Tutu72byte/Guitar-effects-processor---Hardware/3D_MODEL.png

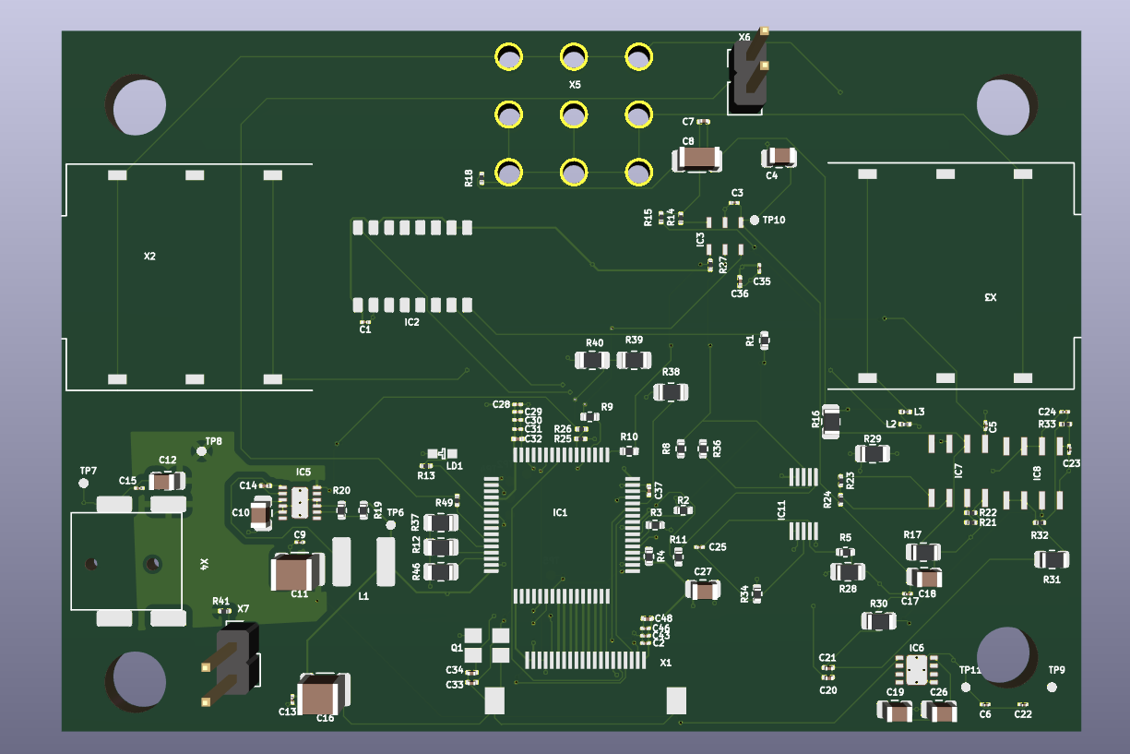
3D_MODEL.png
