Tutu72byte/Guitar-effects-processor---Hardware/Block_Diagram.png

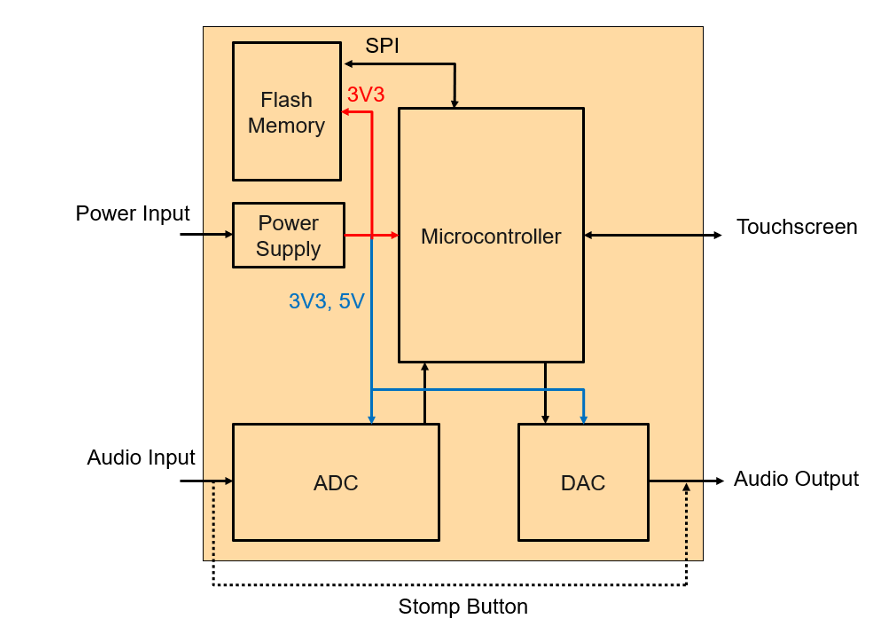
Block_Diagram.png
