Tutu72byte/Guitar-effects-processor---Hardware/PCB.png

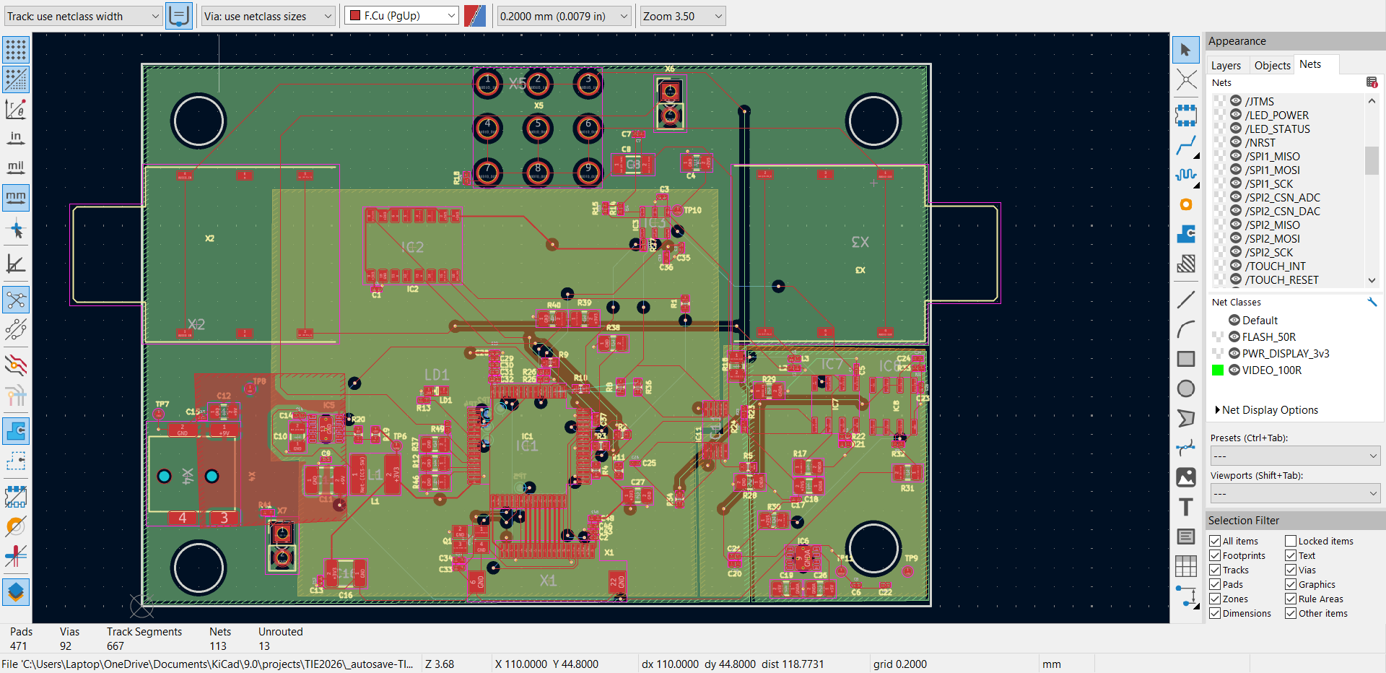
PCB.png
