Tutu72byte/Guitar-effects-processor---Hardware/SCHEMATIC.png

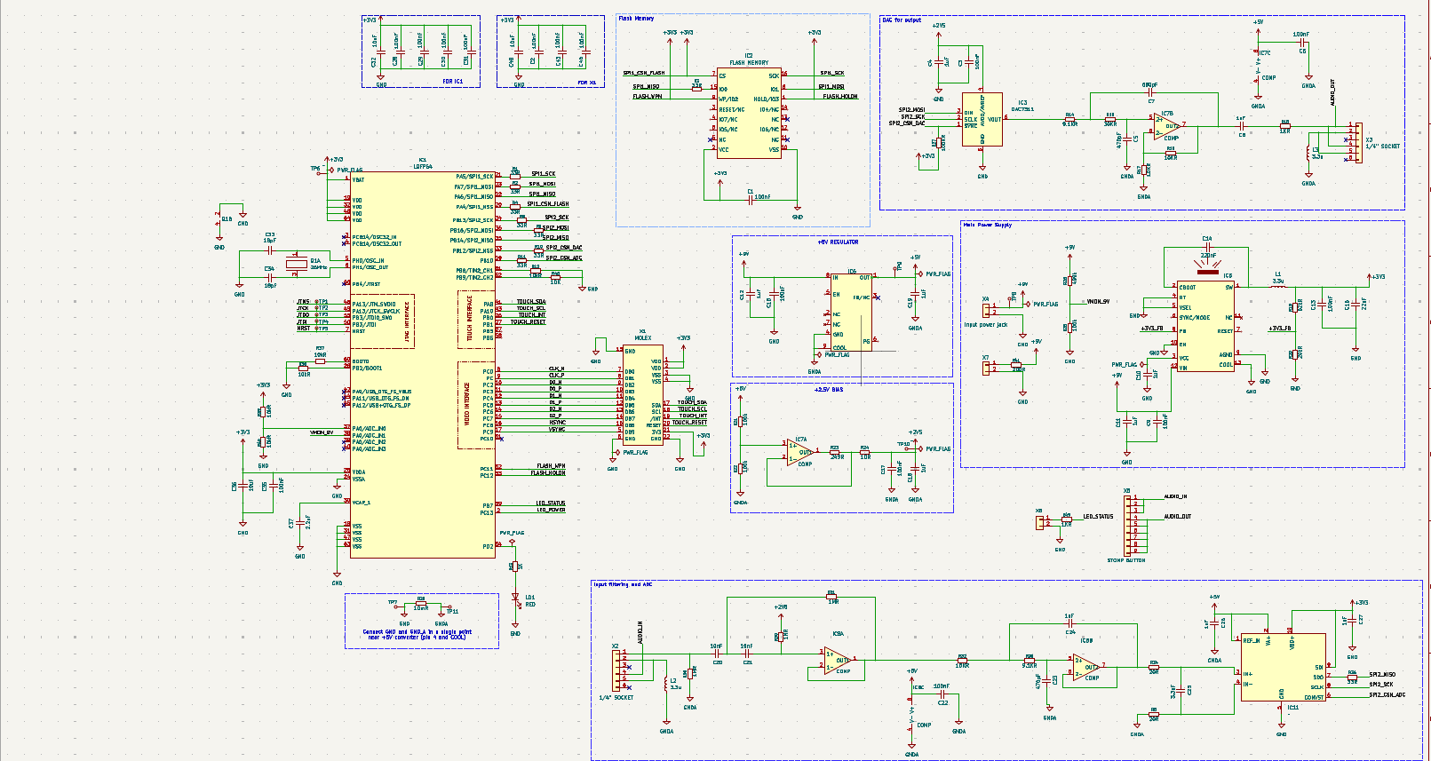
SCHEMATIC.png
