Tutu72byte/Guitar-effects-processor---Hardware/fabrication/BOM/TIE2026_BOM.csv

Reference | Qty | Value | DNP | Exclude from BOM | Exclude from Board | Footprint | Datasheet
C1,C2,C3,C6,C9,C13,C15,C17,C22,C28,C29,C30,C31,C35,C43,C46 | 16 | 100nF |  |  |  | Capacitor_SMD:C_01005_0402Metric | ~
C4,C10,C12,C18,C19,C26,C27 | 7 | 1uF |  |  |  | Capacitor_SMD:C_0805_2012Metric | ~
C5,C23 | 2 | 470pF |  |  |  | Capacitor_SMD:C_01005_0402Metric | ~
C7 | 1 | 680pF |  |  |  | Capacitor_SMD:C_0201_0603Metric | ~
C8 | 1 | 1uF |  |  |  | Capacitor_SMD:C_1206_3216Metric | ~
C11 | 1 | 1uF |  |  |  | Capacitor_SMD:C_1210_3225Metric | ~
C14 | 1 | 220nF |  |  |  | Capacitor_SMD:C_0201_0603Metric | ~
C16 | 1 | 22uF |  |  |  | Capacitor_SMD:C_1210_3225Metric | ~
C20,C21 | 2 | 10nF |  |  |  | Capacitor_SMD:C_0201_0603Metric | ~
C24 | 1 | 1nF |  |  |  | Capacitor_SMD:C_01005_0402Metric | ~
C25 | 1 | 3.3nF |  |  |  | Capacitor_SMD:C_01005_0402Metric | ~
C32,C36,C48 | 3 | 10uF |  |  |  | Capacitor_SMD:C_0201_0603Metric | ~
C33,C34 | 2 | 18pF |  |  |  | Capacitor_SMD:C_0201_0603Metric | ~
C37 | 1 | 2.2uF |  |  |  | Capacitor_SMD:C_0201_0603Metric | ~
IC1 | 1 | LQFP64 |  |  |  | TIE2026:IC1_LQFP64
IC2 | 1 | FLASH MEMORY |  |  |  | TIE2026:IC2_SO16
IC3 | 1 | DAC7311 |  |  |  | TIE2026:IC3_TSOP6 | https://www.ti.com/lit/ds/symlink/dac5311.pdf
IC5 | 1 | ~ |  |  |  | TIE2026:IC5_WSON12
IC6 | 1 | TPS74501PQWDRBRQ1 |  |  |  | TIE2026:IC6_SONB
IC7,IC8 | 2 | COMP |  |  |  | TIE2026:8AB_PDS08 | ~
IC11 | 1 | ~ |  |  |  | TIE2026:IC11_VSSOP
L1 | 1 | 3.3u |  |  |  | TIE2026:L1_NRS5040 | ~
L2,L3 | 2 | 3.3u |  |  |  | Inductor_SMD:L_0201_0603Metric | ~
LD1 | 1 | RED |  |  |  | TIE2026:LD1_PLCC | ~
Q1 | 1 | ~ |  |  |  | TIE2026:Q1_NX3225
R1,R2,R3,R4,R8,R9,R10,R11,R36 | 9 | 33R |  |  |  | Resistor_SMD:R_0402_1005Metric | ~
R5,R34 | 2 | 20R |  |  |  | Resistor_SMD:R_0402_1005Metric | ~
R12,R37,R38,R39,R40 | 5 | 10kR |  |  |  | Resistor_SMD:R_0805_2012Metric | ~
R13 | 1 | 1K |  |  |  | Resistor_SMD:R_0201_0603Metric | ~
R14,R33 | 2 | 9.1KR |  |  |  | Resistor_SMD:R_0201_0603Metric | ~
R15 | 1 | 30KR |  |  |  | Resistor_SMD:R_0201_0603Metric | ~
R16,R17 | 2 | 10KR |  |  |  | Resistor_SMD:R_0805_2012Metric | ~
R18,R49 | 2 | 1KR |  |  |  | Resistor_SMD:R_0201_0603Metric | ~
R19 | 1 | 62kR |  |  |  | Resistor_SMD:R_0402_1005Metric | ~
R20 | 1 | 20kR |  |  |  | Resistor_SMD:R_0402_1005Metric | ~
R21,R22,R25 | 3 | 100k |  |  |  | Resistor_SMD:R_0201_0603Metric | ~
R23 | 1 | 249R |  |  |  | Resistor_SMD:R_0201_0603Metric | ~
R24 | 1 | 10R |  |  |  | Resistor_SMD:R_0201_0603Metric | ~
R26 | 1 | 499k |  |  |  | Resistor_SMD:R_0201_0603Metric | ~
R27 | 1 | 100KR |  |  |  | Resistor_SMD:R_0201_0603Metric | ~
R28 | 1 | 10mR |  |  |  | Resistor_SMD:R_0805_2012Metric | ~
R29,R30,R31 | 3 | 1MR |  |  |  | Resistor_SMD:R_0805_2012Metric | ~
R32 | 1 | 15KR |  |  |  | Resistor_SMD:R_0201_0603Metric | ~
R41 | 1 | 200R |  |  |  | Resistor_SMD:R_0201_0603Metric | ~
R46 | 1 | 10K |  |  |  | Resistor_SMD:R_0805_2012Metric | ~
TP1,TP2,TP3,TP4,TP5,TP6,TP7,TP8,TP9,TP10,TP11 | 11 | ~ |  |  |  | TIE2026:TEST_POINT_TIE2026 | ~
X1 | 1 | MOLEX |  |  |  | TIE2026:X1_MOLEX
X2,X3 | 2 | 1/4" SOCKET |  |  |  | TIE2026:QInch_Jack | ~
X4 | 1 | Input power jack |  |  |  | TIE2026:ADC_021_3 | ~
X5 | 1 | STOMP BUTTON |  |  |  | TIE2026:XC5_MC71101 | ~
X6,X7 | 2 | CONN_2.54 |  |  |  | Connector_PinHeader_2.54mm:PinHeader_1x02_P2.54mm_Vertical | ~
