Tutu72byte/Guitar-effects-processor---Hardware/TIE2026.kicad_pcb

## KiCad design TIE2026.kicad_pcb (2026-05-31)

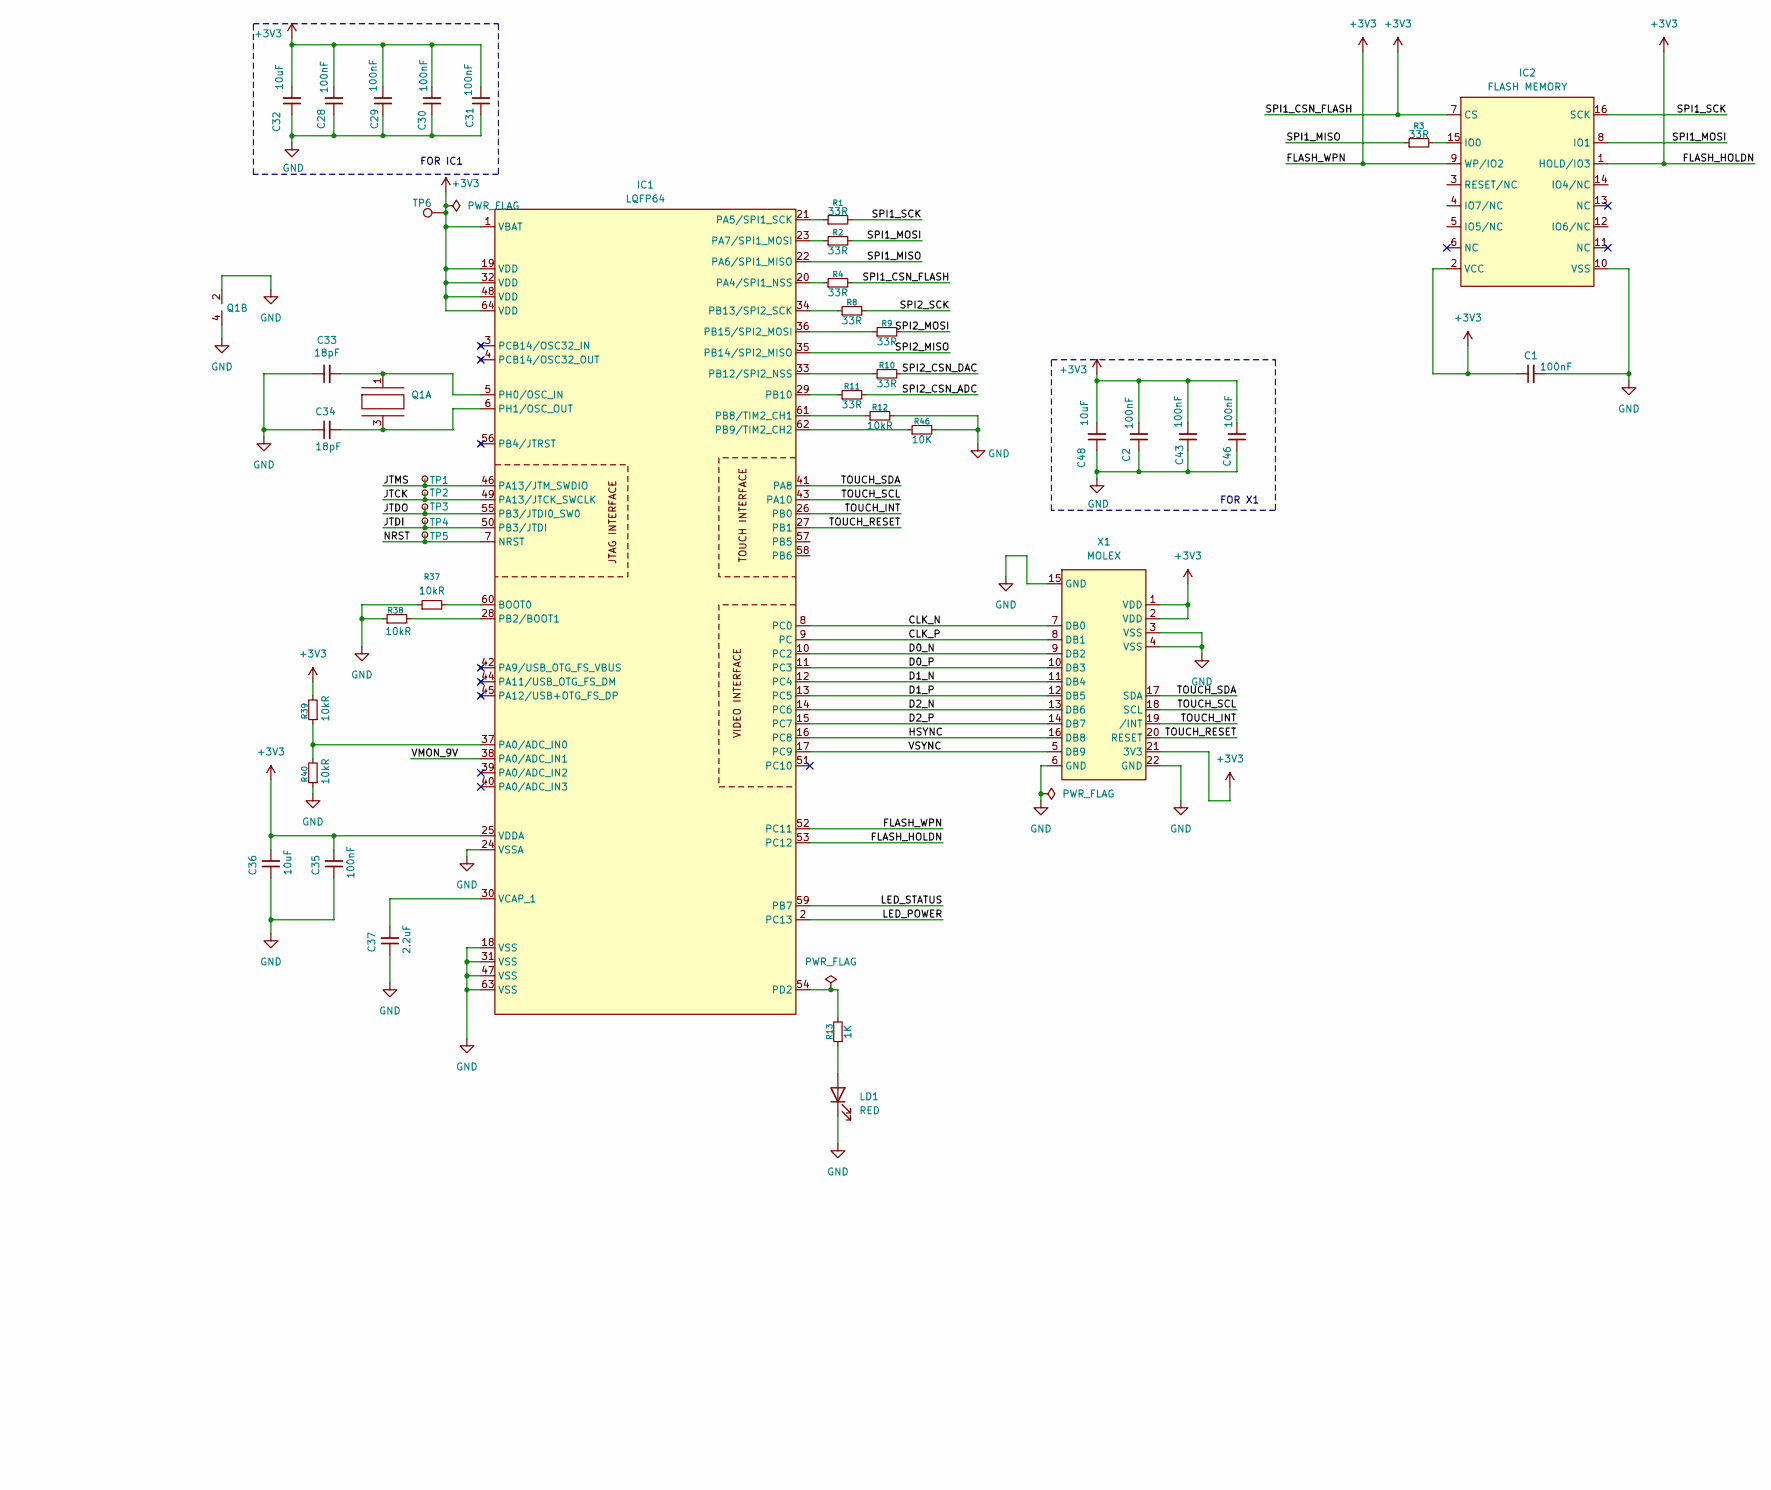
[picture p5: schematic TIE2026.kicad_sch, SCH TIE AA, part in row 1, column 2]

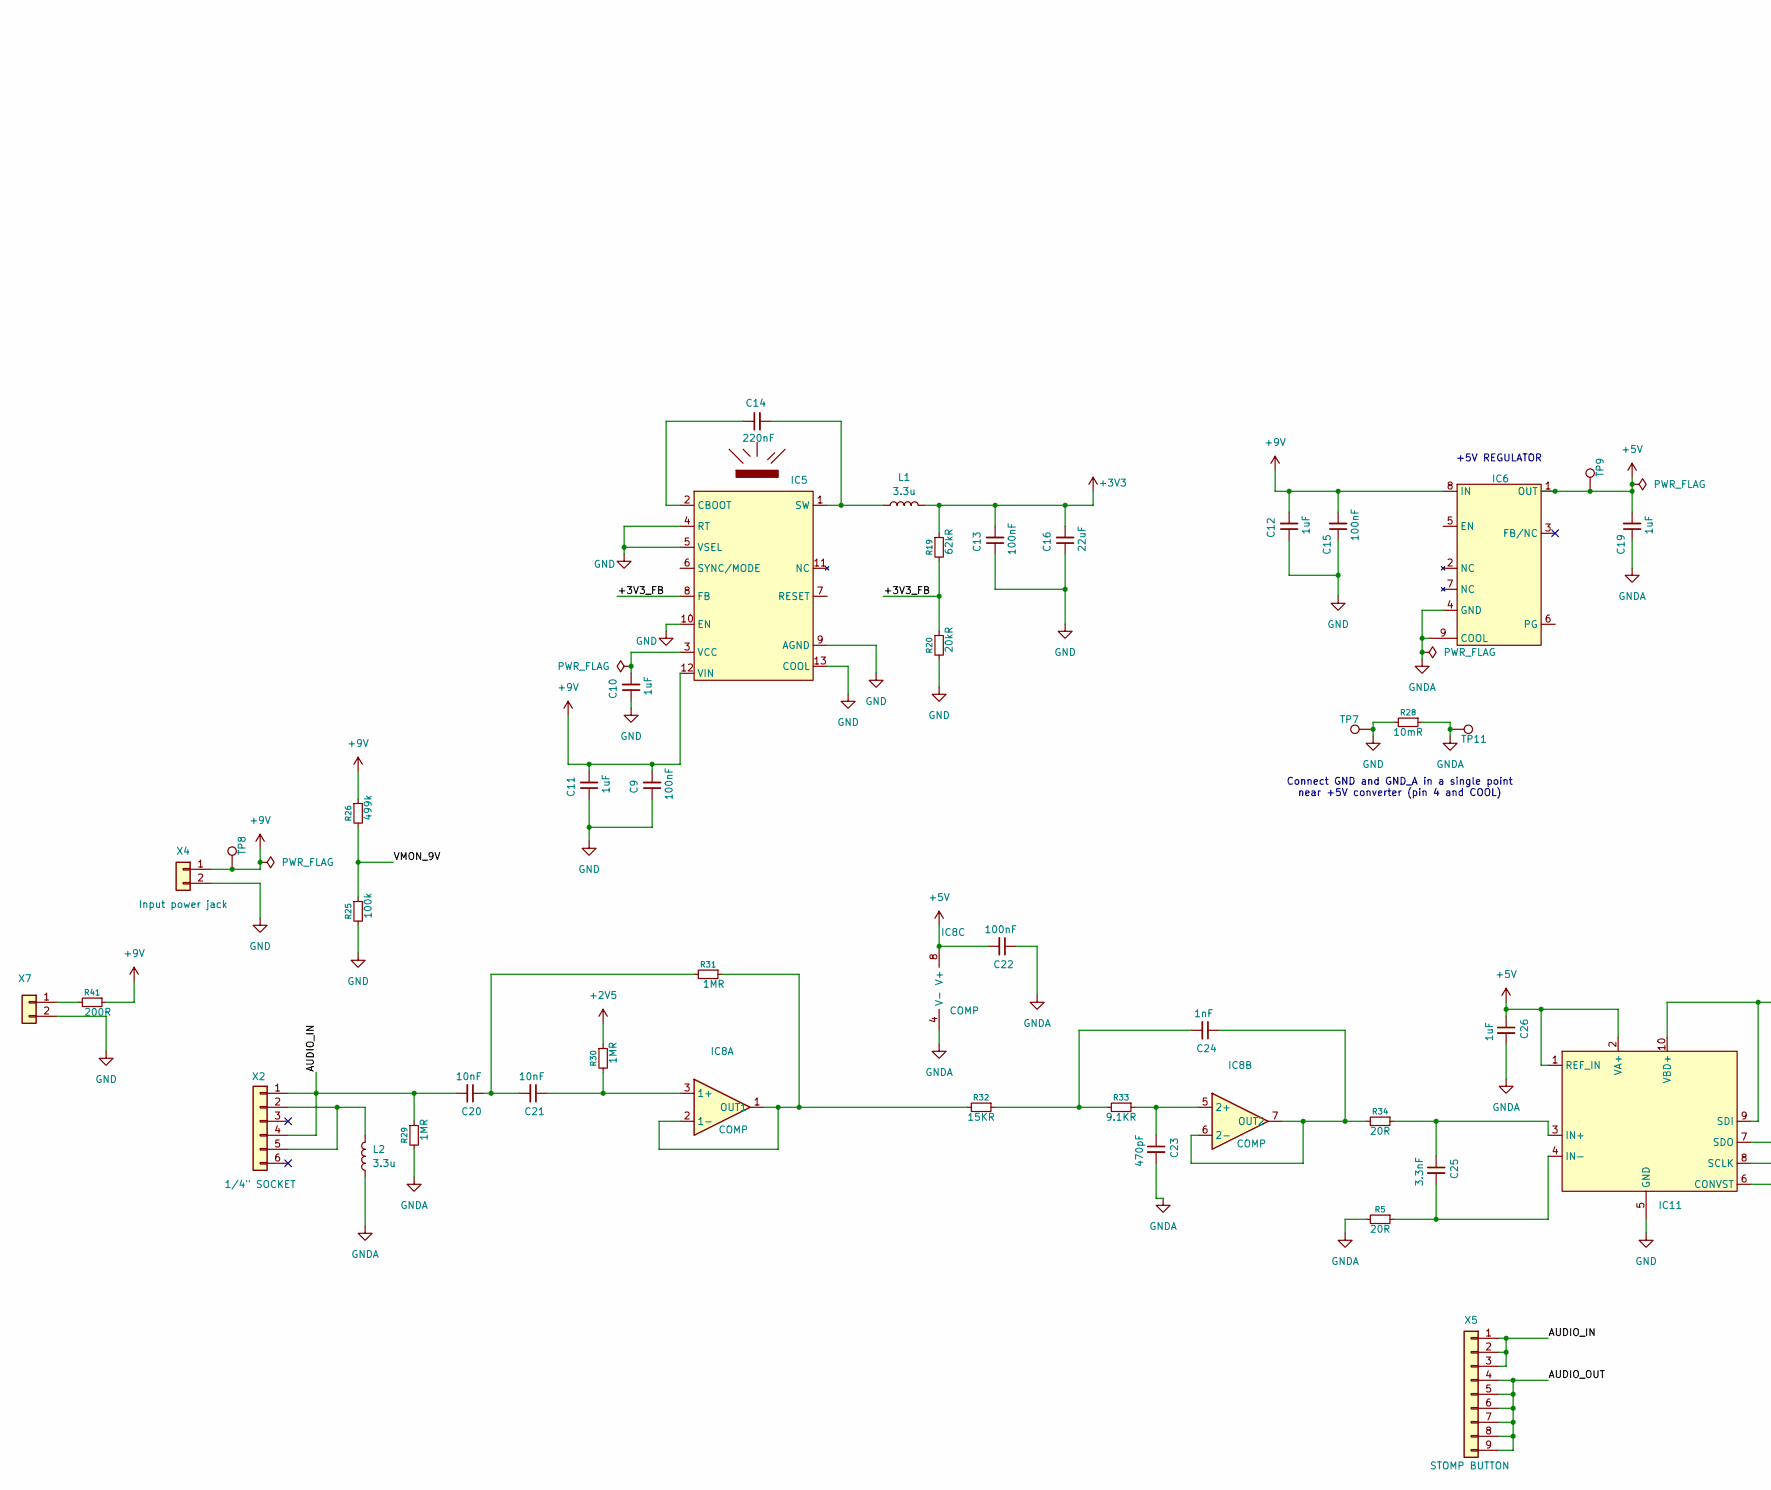
[picture p6: schematic TIE2026.kicad_sch, SCH TIE AA, part in row 2, column 1]

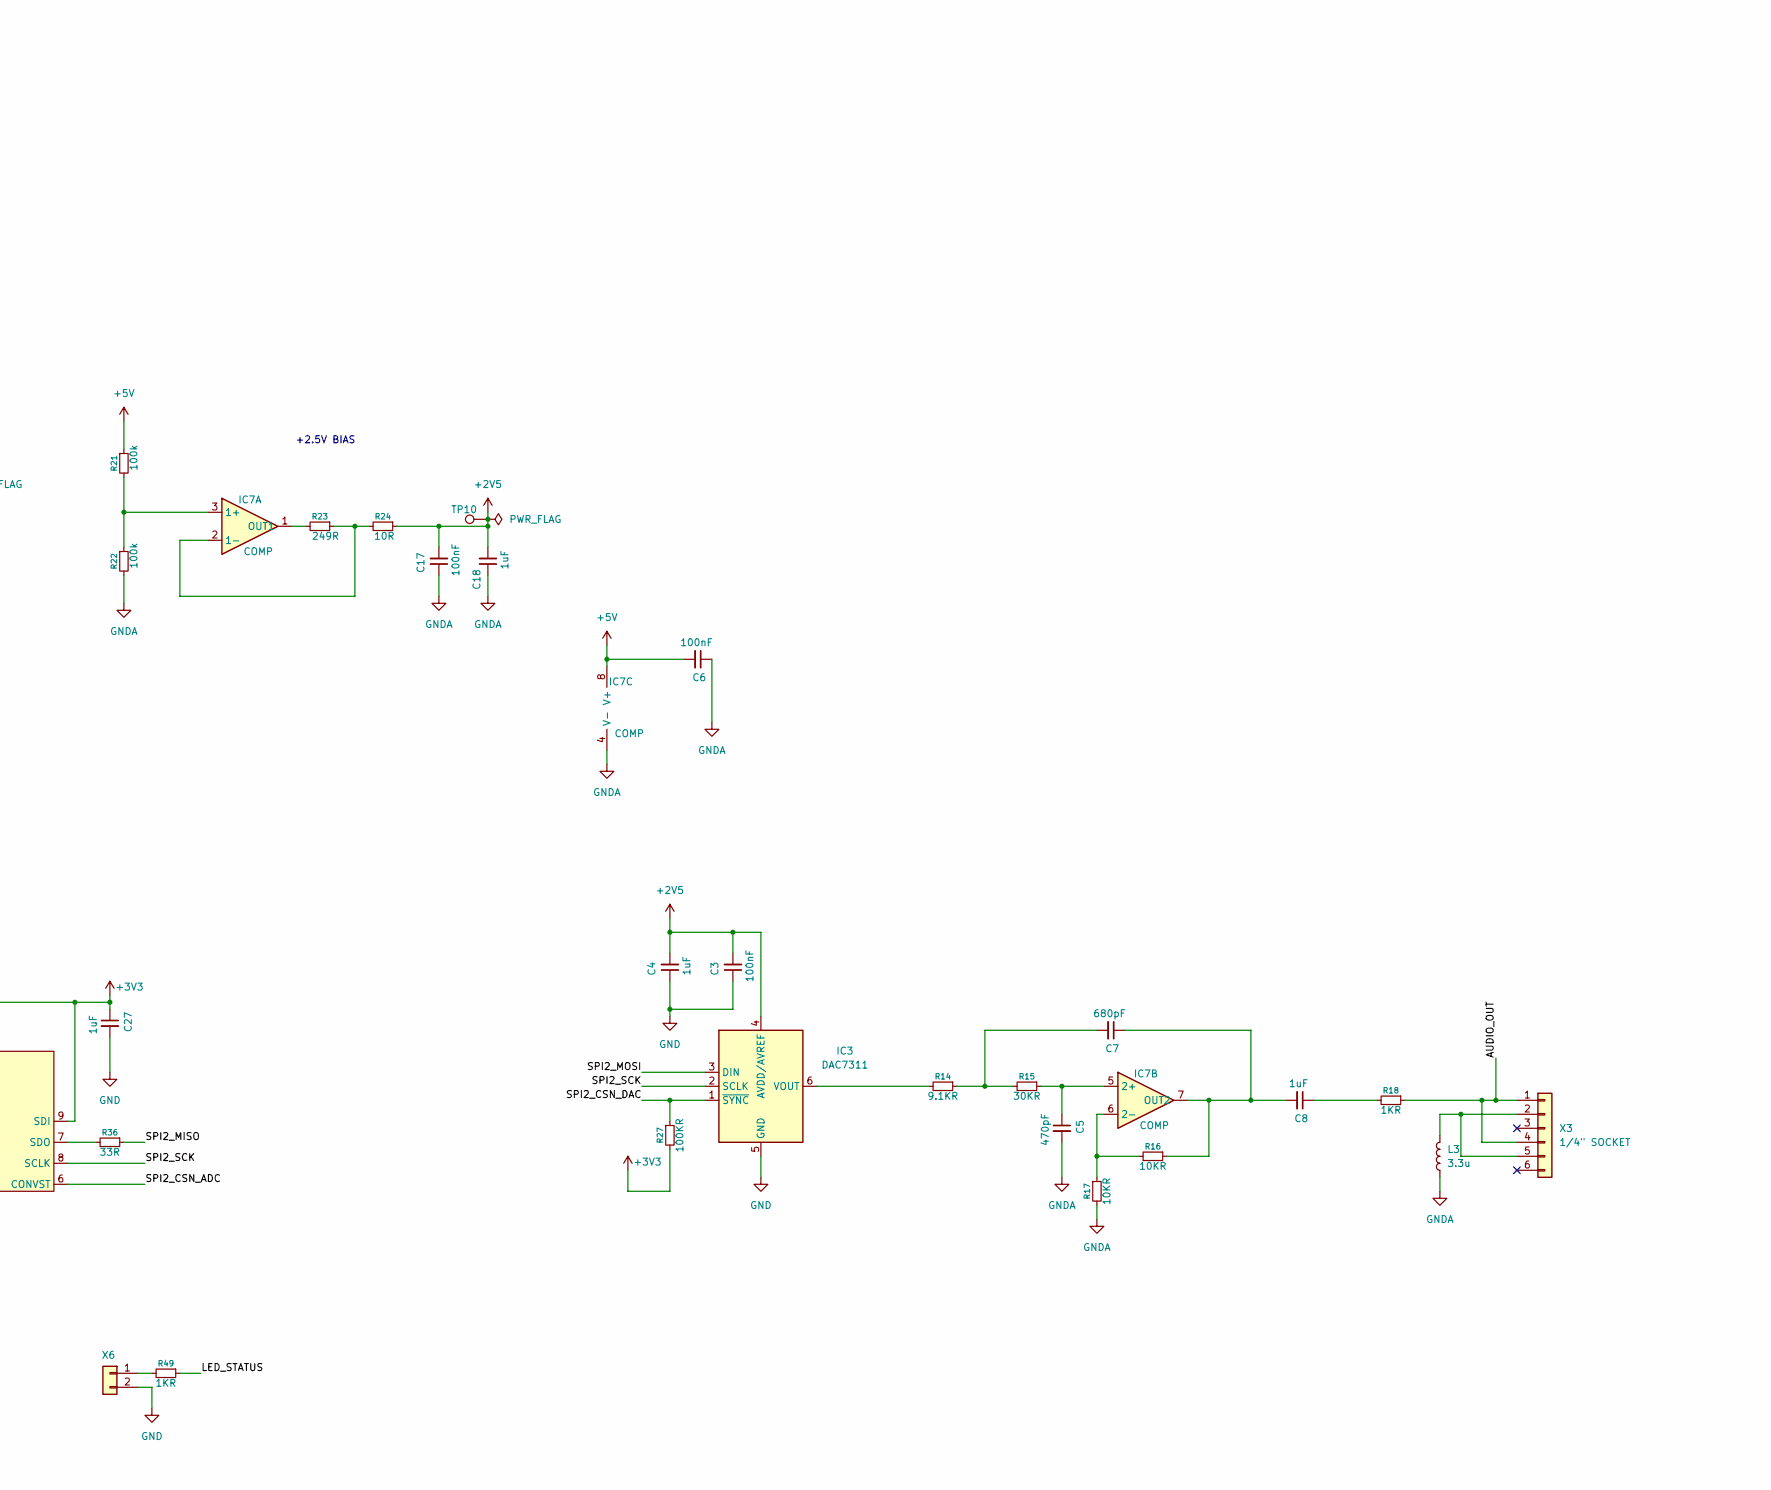
[picture p7: schematic TIE2026.kicad_sch, SCH TIE AA, part in row 2, column 2]

Parts:
C1, C2, C3, C6, C9, C13, C15, C17, C22, C28, C29, C30, C31, C35, C43, C46: 100nF; C_01005_0402Metric
C4, C10, C12, C18, C19, C26, C27: 1uF; C_0805_2012Metric
C5, C23: 470pF; C_01005_0402Metric
C7: 680pF; C_0201_0603Metric
C8: 1uF; C_1206_3216Metric
C11: 1uF; C_1210_3225Metric
C14: 220nF; C_0201_0603Metric
C16: 22uF; C_1210_3225Metric
C20, C21: 10nF; C_0201_0603Metric
C24: 1nF; C_01005_0402Metric
C25: 3.3nF; C_01005_0402Metric
C32, C36, C48: 10uF; C_0201_0603Metric
C33, C34: 18pF; C_0201_0603Metric
C37: 2.2uF; C_0201_0603Metric
IC1: LQFP64; IC1_LQFP64
IC2: FLASH MEMORY; IC2_SO16
IC3: DAC7311; IC3_TSOP6
IC5: IC5_WSON12
IC6: TPS74501PQWDRBRQ1; IC6_SONB
IC7, IC8: COMP; 8AB_PDS08
IC11: IC11_VSSOP
L1: 3.3u; L1_NRS5040
L2, L3: 3.3u; L_0201_0603Metric
LD1: RED; LD1_PLCC
Q1: Q1_NX3225
R1, R2, R3, R4, R8, R9, R10, R11, R36: 33R; R_0402_1005Metric
R5, R34: 20R; R_0402_1005Metric
R12, R37, R38, R39, R40: 10kR; R_0805_2012Metric
R13: 1K; R_0201_0603Metric
R14, R33: 9.1KR; R_0201_0603Metric
R15: 30KR; R_0201_0603Metric
R16, R17: 10KR; R_0805_2012Metric
R18, R49: 1KR; R_0201_0603Metric
R19: 62kR; R_0402_1005Metric
R20: 20kR; R_0402_1005Metric
R21, R22, R25: 100k; R_0201_0603Metric
R23: 249R; R_0201_0603Metric
R24: 10R; R_0201_0603Metric
R26: 499k; R_0201_0603Metric
R27: 100KR; R_0201_0603Metric
R28: 10mR; R_0805_2012Metric
R29, R30, R31: 1MR; R_0805_2012Metric
R32: 15KR; R_0201_0603Metric
R41: 200R; R_0201_0603Metric
R46: 10K; R_0805_2012Metric
TP1, TP2, TP3, TP4, TP5, TP6, TP7, TP8, TP9, TP10, TP11: TEST_POINT_TIE2026
X1: MOLEX; X1_MOLEX
X2, X3: 1/4" SOCKET; QInch_Jack
X4: Input power jack; ADC_021_3
X5: STOMP BUTTON; XC5_MC71101
X6, X7: CONN_2.54; PinHeader_1x02_P2.54mm_Vertical

Connections:
+2V5: C3.2, C4.2, C17.2, C18.2, IC3.4 (AVDD/AVREF), R24.1, R30.1, TP10.1
+3V3: C1.1, C2.2, C13.2, C16.2, C27.1, C28.2, C29.2, C30.2, C31.2, C32.2, C35.2, C36.2, C43.2, C46.2, C48.2, IC1.1 (VBAT), IC1.19 (VDD), IC1.25 (VDDA), IC1.32 (VDD), IC1.48 (VDD), IC1.52 (PC11), IC1.53 (PC12), IC1.64 (VDD), IC2.1 (HOLD/IO3), IC2.2 (VCC), IC2.7 (CS), IC2.9 (WP/IO2), IC11.9 (SDI), IC11.10 (VBD+), L1.2, R4.2, R19.1, R27.2, R39.2, TP6.1, X1.1 (VDD), X1.2 (VDD), X1.21 (3V3)
+5V: C6.2, C19.2, C22.2, C26.1, IC6.1 (OUT), IC7.8 (V+), IC8.8 (V+), IC11.1 (REF_IN), IC11.2 (VA+), R21.1, TP9.1
+9V: C9.2, C11.2, C12.2, C15.2, IC5.12 (VIN), IC6.8 (IN), R26.1, R41.1, TP8.1, X4.1
/+3V3_FB: IC5.8 (FB), R19.2, R20.1
/AUDIO_IN: C20.2, R29.1, X2.1, X2.4, X5.1, X5.2, X5.3
/AUDIO_OUT: R18.1, X3.1, X3.4, X5.4, X5.5, X5.6, X5.7, X5.8, X5.9
/CLK_N: IC1.8 (PC0), X1.7 (DB0)
/CLK_P: IC1.9 (PC), X1.8 (DB1)
/D0_N: IC1.10 (PC2), X1.9 (DB2)
/D0_P: IC1.11 (PC3), X1.10 (DB3)
/D1_N: IC1.12 (PC4), X1.11 (DB4)
/D1_P: IC1.13 (PC5), X1.12 (DB5)
/D2_N: IC1.14 (PC6), X1.13 (DB6)
/D2_P: IC1.15 (PC7), X1.14 (DB7)
/HSYNC: IC1.16 (PC8), X1.16 (DB8)
/JTCK: IC1.49 (PA13/JTCK_SWCLK), TP2.1
/JTDI: IC1.50 (PB3/JTDI), TP4.1
/JTDO: IC1.55 (PB3/JTDI0_SW0), TP3.1
/JTMS: IC1.46 (PA13/JTM_SWDIO), TP1.1
/LED_POWER: IC1.2 (PC13)
/LED_STATUS: IC1.59 (PB7), R49.1
/NRST: IC1.7 (NRST), TP5.1
/SPI1_MISO: IC1.22 (PA6/SPI1_MISO), R3.1
/SPI1_MOSI: IC2.8 (IO1), R2.2
/SPI1_SCK: IC2.16 (SCK), R1.2
/SPI2_CSN_ADC: IC11.6 (CONVST), R11.2
/SPI2_CSN_DAC: IC3.1 (~SYNC), R10.2, R27.1
/SPI2_MISO: IC1.35 (PB14/SPI2_MISO), R36.1
/SPI2_MOSI: IC3.3 (DIN), R9.2
/SPI2_SCK: IC3.2 (SCLK), IC11.8 (SCLK), R8.2
/TOUCH_INT: IC1.26 (PB0), X1.19 (/INT)
/TOUCH_RESET: IC1.27 (PB1), X1.20 (RESET)
/TOUCH_SCL: IC1.43 (PA10), X1.18 (SCL)
/TOUCH_SDA: IC1.41 (PA8), X1.17 (SDA)
/VMON_9V: IC1.38 (PA0/ADC_IN1), R25.1, R26.2
/VSYNC: IC1.17 (PC9), X1.5 (DB9)
GND: C1.2, C2.1, C3.1, C4.1, C9.1, C10.1, C11.1, C12.1, C13.1, C15.1, C16.1, C27.2, C28.1, C29.1, C30.1, C31.1, C32.1, C33.1, C34.1, C35.1, C36.1, C37.1, C43.1, C46.1, C48.1, IC1.18 (VSS), IC1.24 (VSSA), IC1.31 (VSS), IC1.47 (VSS), IC1.63 (VSS), IC2.10 (VSS), IC3.5 (GND), IC5.4 (RT), IC5.5 (VSEL), IC5.9 (AGND), IC5.10 (EN), IC5.13 (COOL), IC11.5 (GND), LD1.1 (K), Q1.2, Q1.4, R12.2, R20.2, R25.2, R28.2, R37.1, R38.1, R40.1, R46.2, TP7.1, X1.3 (VSS), X1.4 (VSS), X1.6 (GND), X1.15 (GND), X1.22 (GND), X4.2, X6.2, X7.2
GNDA: C5.2, C6.1, C17.1, C18.1, C19.1, C22.1, C23.2, C26.2, IC6.4 (GND), IC6.9 (COOL), IC7.4 (V-), IC8.4 (V-), L2.1, L3.1, R5.2, R17.2, R22.2, R28.1, R29.2, TP11.1
unnamed: C7.2, R14.1, R15.2
unnamed: C8.1, R18.2
unnamed: C20.1, C21.2, R31.2
unnamed: C24.2, R32.1, R33.2
unnamed: IC1.60 (BOOT0), R37.2
unnamed: IC1.37 (PA0/ADC_IN0), R39.1, R40.2
unnamed: IC1.20 (PA4/SPI1_NSS), R4.1
unnamed: IC1.21 (PA5/SPI1_SCK), R1.1
unnamed: IC1.23 (PA7/SPI1_MOSI), R2.1
unnamed: IC1.28 (PB2/BOOT1), R38.2
unnamed: IC1.61 (PB8/TIM2_CH1), R12.1
unnamed: IC1.62 (PB9/TIM2_CH2), R46.1
unnamed: IC1.29 (PB10), R11.1
unnamed: IC1.33 (PB12/SPI2_NSS), R10.1
unnamed: IC1.34 (PB13/SPI2_SCK), R8.1
unnamed: IC1.36 (PB15/SPI2_MOSI), R9.1
unnamed: IC1.54 (PD2), R13.2
unnamed: C33.2, IC1.5 (PH0/OSC_IN), Q1.1
unnamed: C34.2, IC1.6 (PH1/OSC_OUT), Q1.3
unnamed: C37.2, IC1.30 (VCAP_1)
unnamed: IC2.15 (IO0), R3.2
unnamed: IC3.6 (VOUT), R14.2
unnamed: C14.1, IC5.2 (CBOOT)
unnamed: C14.2, IC5.1 (SW), L1.1
unnamed: C10.2, IC5.3 (VCC)
unnamed: IC7.3 (1+), R21.2, R22.1
unnamed: IC7.2 (1-), R23.1, R24.2
unnamed: IC7.1 (OUT1), R23.2
unnamed: C5.1, IC7.5 (2+), R15.1
unnamed: IC7.6 (2-), R16.2, R17.1
unnamed: C7.1, C8.2, IC7.7 (OUT2), R16.1
unnamed: C21.1, IC8.3 (1+), R30.2
unnamed: IC8.1 (OUT1), IC8.2 (1-), R31.1, R32.2
unnamed: C23.1, IC8.5 (2+), R33.1
unnamed: C24.1, IC8.6 (2-), IC8.7 (OUT2), R34.2
unnamed: C25.1, IC11.3 (IN+), R34.1
unnamed: C25.2, IC11.4 (IN-), R5.1
unnamed: IC11.7 (SDO), R36.2
unnamed: LD1.2 (A), R13.1
unnamed: L2.2, X2.2, X2.5
unnamed: L3.2, X3.2, X3.5
unnamed: R49.2, X6.1
unnamed: R41.2, X7.1

Notes on the sheet:
+5V REGULATOR
FOR X1
FOR IC1
Connect GND and GND_A in a single point near +5V converter (pin 4 and COOL)
+2.5V BIAS

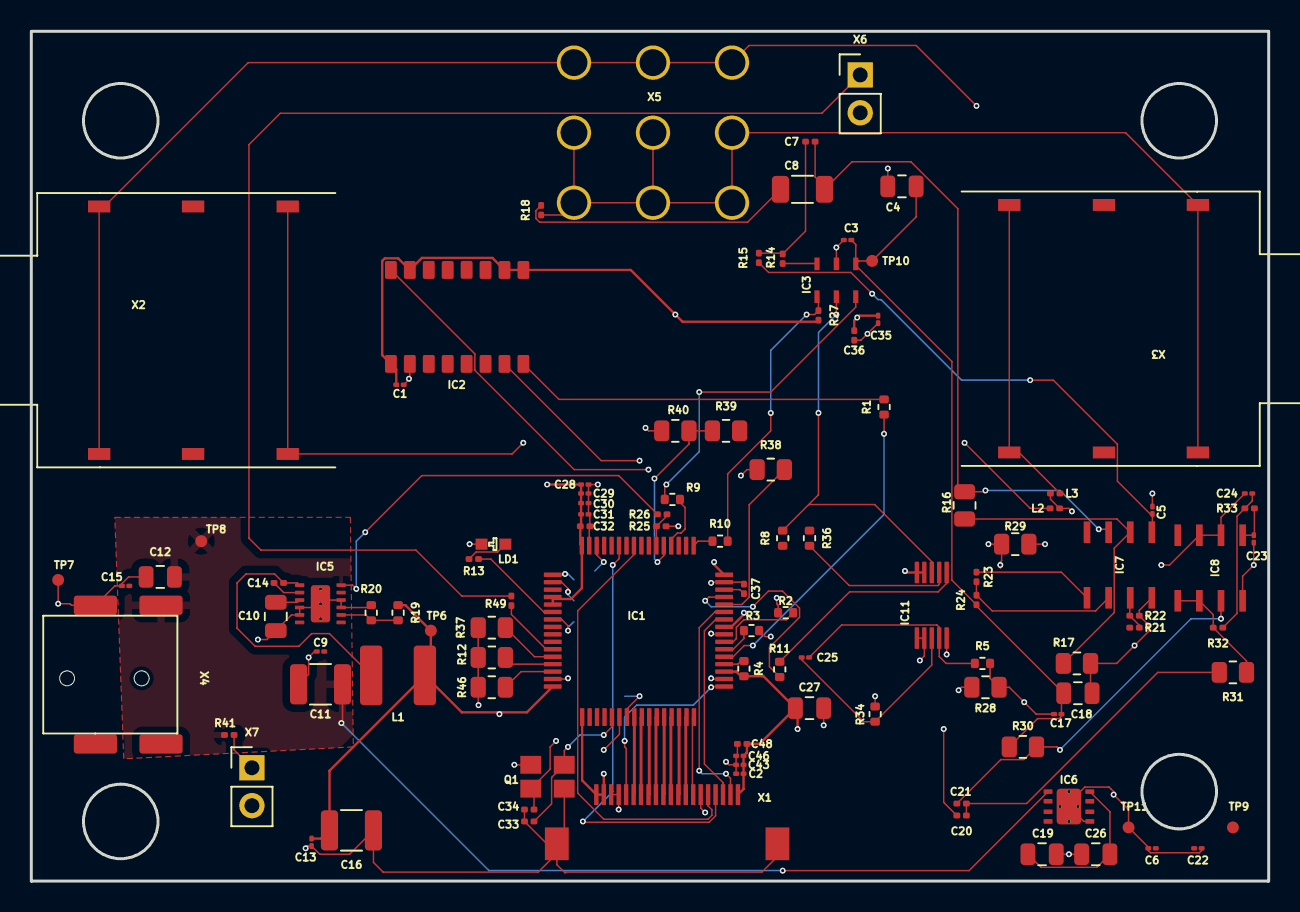
[picture p8: board TIE2026.kicad_pcb from above]

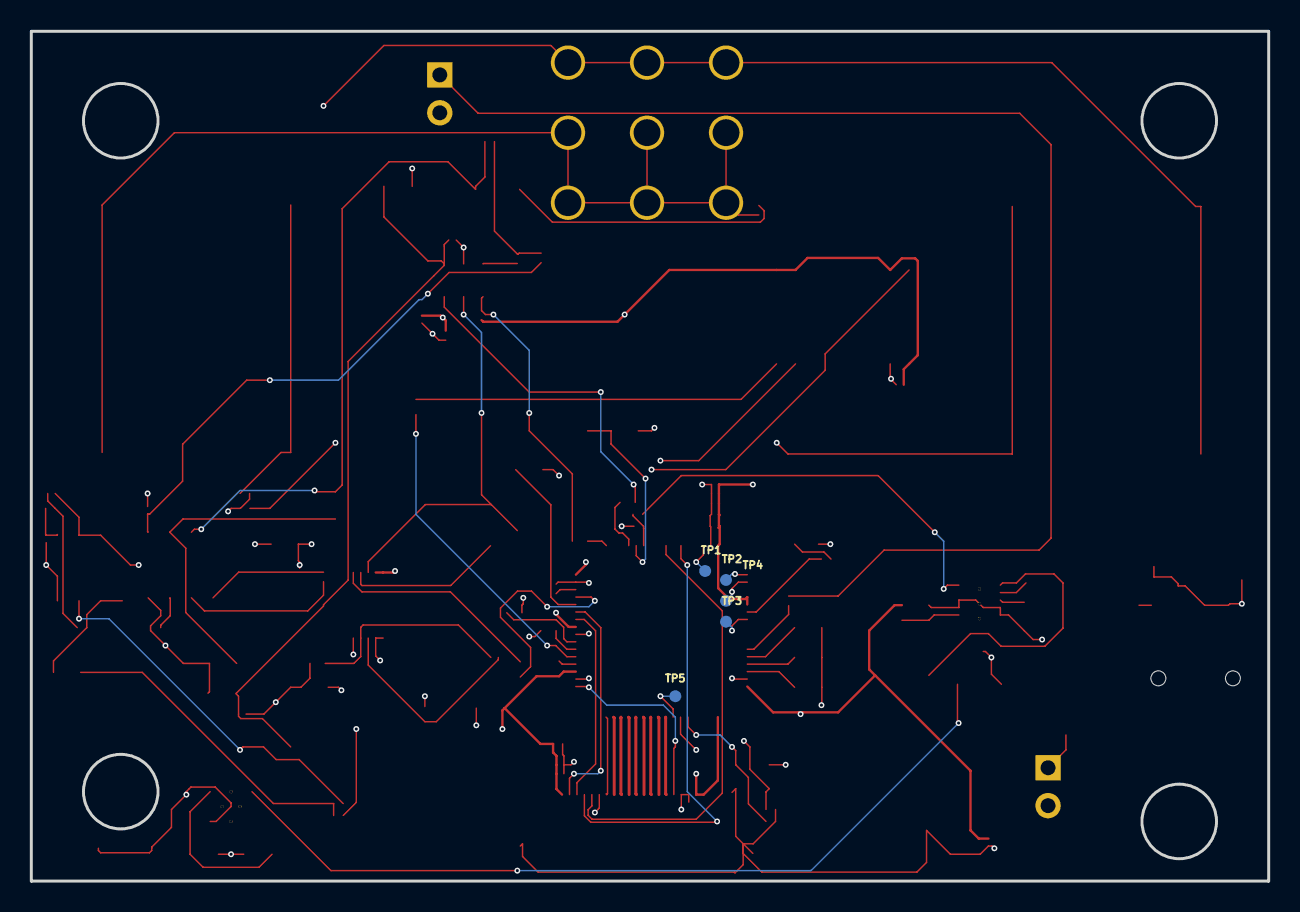
[picture p9: board TIE2026.kicad_pcb from below]

Board: 4 copper layers, 83.0 x 57.0 mm, 111 parts (5 on the bottom side), 81 nets.
