Tutu72byte/Guitar-effects-processor---Hardware/(commit log)

2026-05-31 Initial clean push TIE2026
    [TIE2026-B_Cu.gbr, TIE2026-B_Mask.gbr, TIE2026-B_Paste.gbr, TIE2026-B_Silkscreen.gbr, TIE2026-Edge_Cuts.gbr, TIE2026-F_Cu.gbr, TIE2026-F_Mask.gbr, TIE2026-F_Paste.gbr]
2026-05-31 Add project overview for embedded music signal processor
    Documented the complete hardware development process for an embedded music signal processing module, including library creation, schematic design, PCB topology, routing for high-speed signals, and manufacturing output.
2026-10-29 Added PNGs for Schematic PCB and 3D model
